Cederb/Faceshield.nu/Pictures/breakaway_stack2.jpg

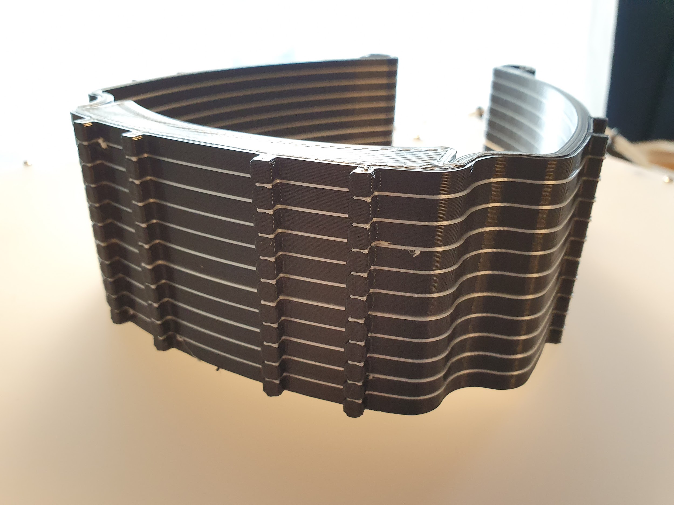
Pictures/breakaway_stack2.jpg
