Cederb/Faceshield.nu/Pictures/breakaway_stack1.jpg

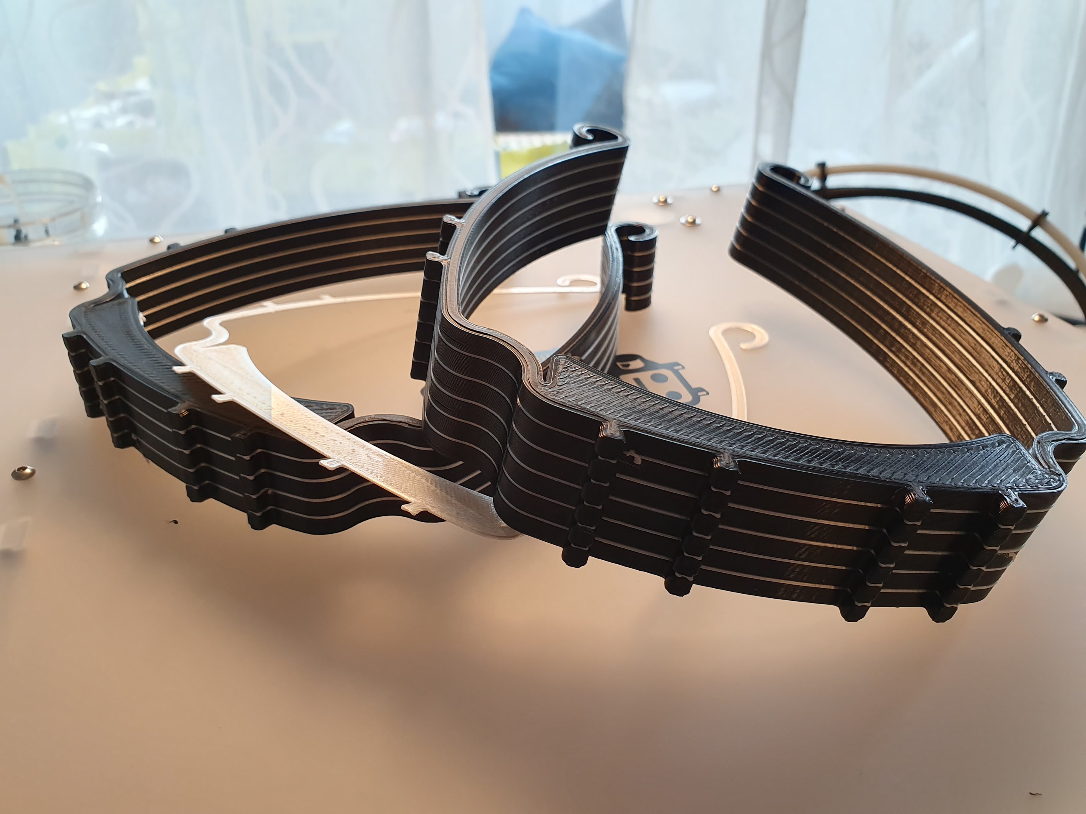
Pictures/breakaway_stack1.jpg
