Cederb/Faceshield.nu/README.md

# Faceshield.nu
 Backup repo for the Faceshield.nu project. Please see http://faceshield.nu for information.
