Cederb/Faceshield.nu/North America 3-hole/Templates & Laser Cutting files/US__3_Hole_Punch_Letter_Template by Bornity.pdf

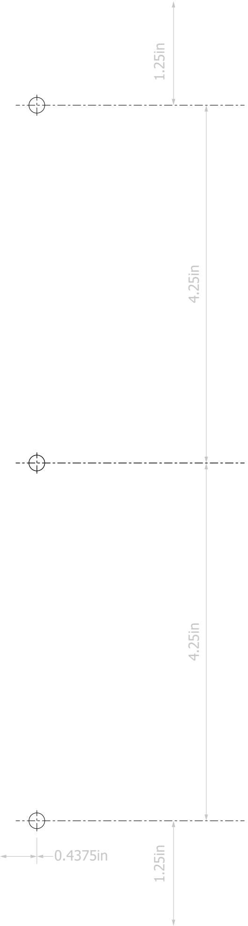
[picture p3: figure]

# 3DVerkstan NA 3-hole Hand Punch Template

# (USES STANDARD USA 3-HOLE PUNCH

)

Created by Rob Stuart (@bornity)

Modified for 3-hole version by Erik Cederberg (@erikcederb)
