Cederb/Faceshield.nu/North America 6-hole/Templates & Laser Cutting files/US__6_Hole_Punch_Letter_Template by Bornity.pdf

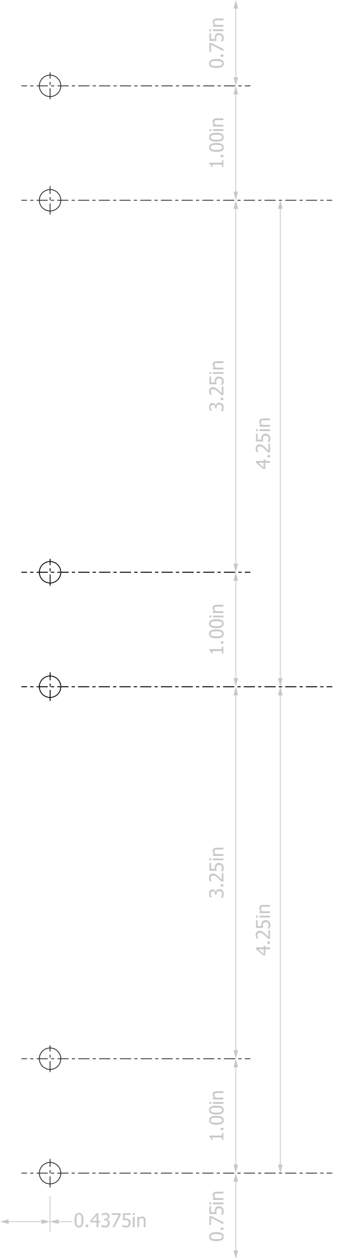
[picture p4: figure]

## 3DVerkstan NA V3 Hand Punch Template

## (USES STANDARD USA 3-HOLE PUNCH TWICE

)

Created by Rob Stuart (@bornity)
