Cederb/Faceshield.nu/Pictures/breakaway_stack3.jpg

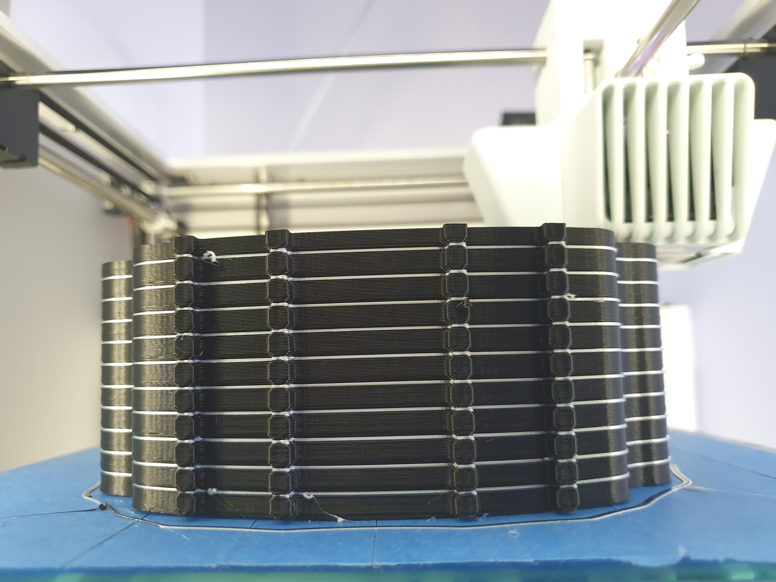
Pictures/breakaway_stack3.jpg
