Cederb/Faceshield.nu/Visor_frame_EUROPE-888-4hole.png

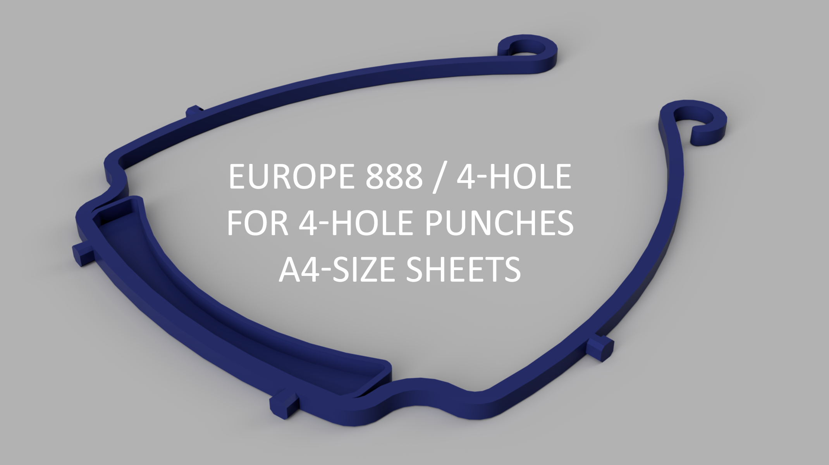
Visor_frame_EUROPE-888-4hole.png
