Cederb/Faceshield.nu/Visor_frame_EUROPE-ISO838_A6.png

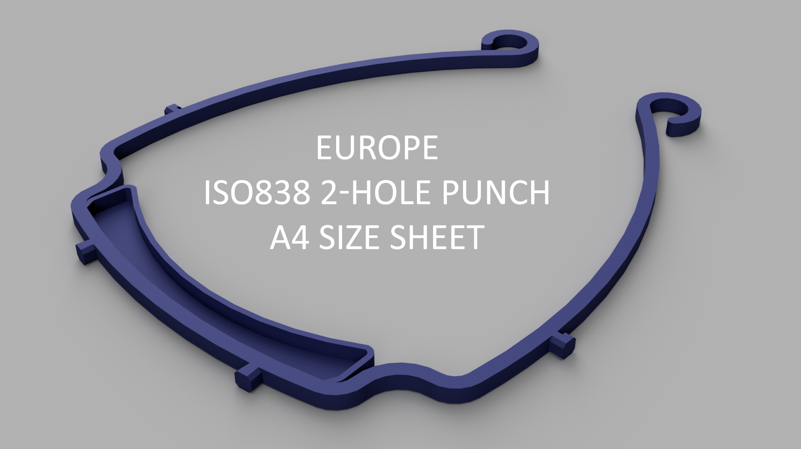
Visor_frame_EUROPE-ISO838_A6.png
