Cederb/Faceshield.nu/Visor_frame_NORTH-AMERICA_3-hole.png

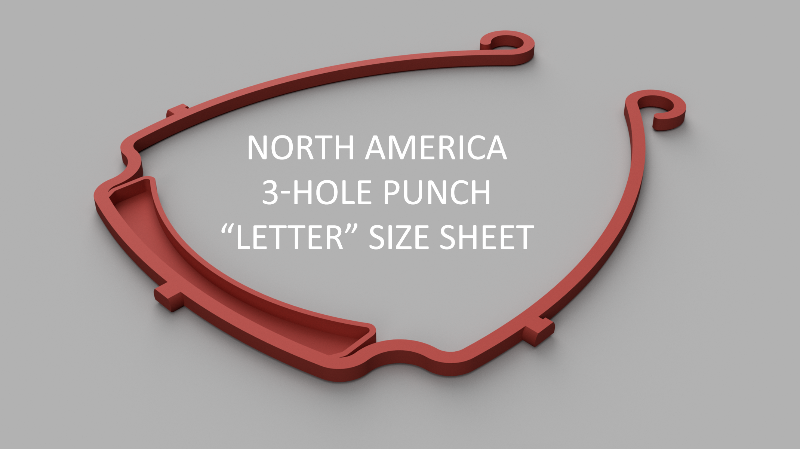
Visor_frame_NORTH-AMERICA_3-hole.png
