Cederb/Faceshield.nu/Visor_frame_NORTH-AMERICA_6-hole.png

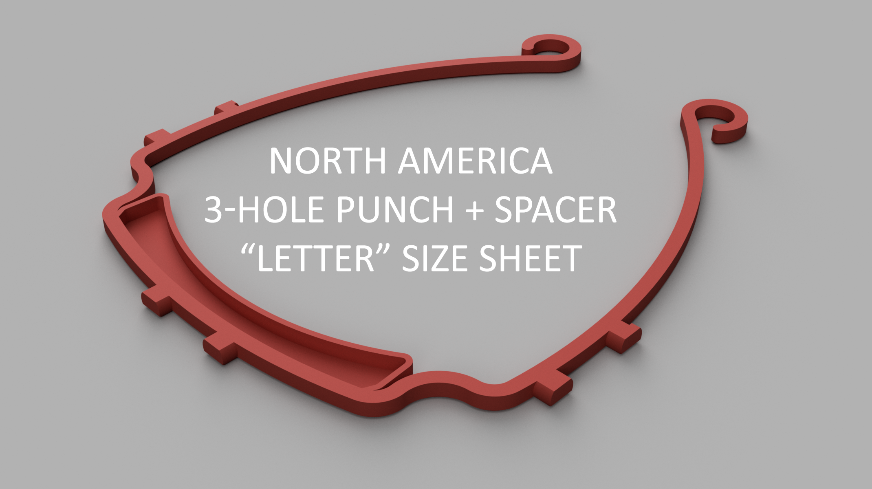
Visor_frame_NORTH-AMERICA_6-hole.png
