Cederb/Faceshield.nu/Visor_frame_PRUSA-COMPATIBLE.png

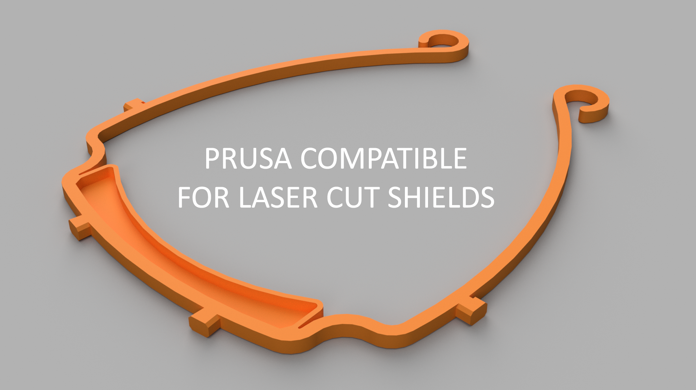
Visor_frame_PRUSA-COMPATIBLE.png
