Cederb/Faceshield.nu/Visor_frame_SWEDEN_A6.png

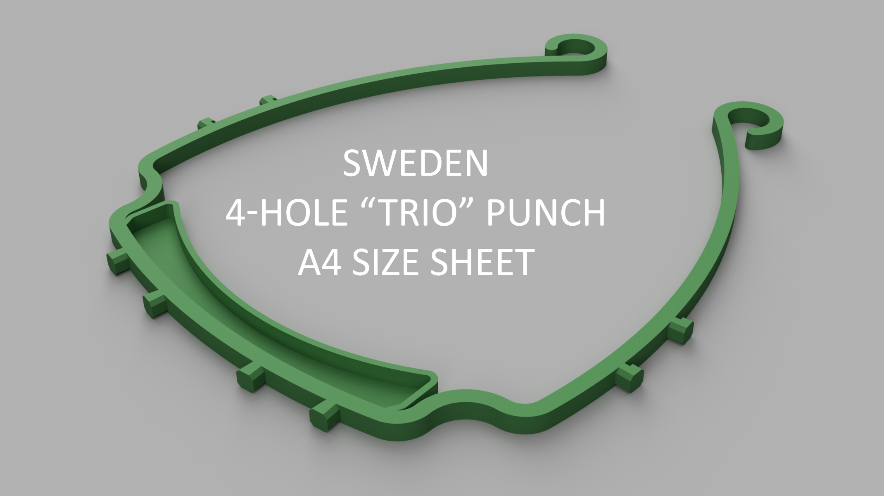
Visor_frame_SWEDEN_A6.png
