Cederb/Faceshield.nu/Europe 888/3D Printing Files (STL)/Stacked Files/For Dual Extrusion Printers/Visor_frame_EUROPE_80mm_4hole_v2-solid_front-support_stack_17pcs_95mm.stl

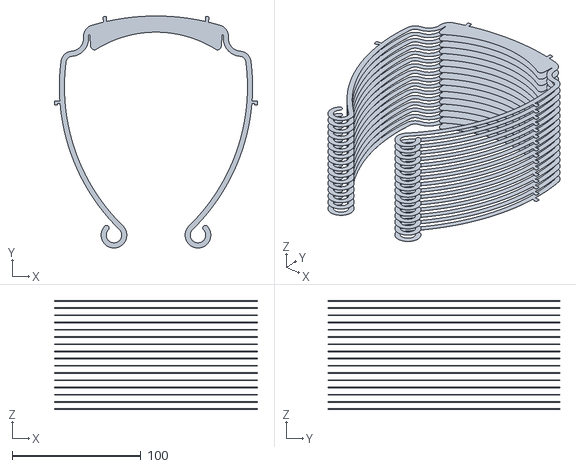
[picture p12: CAD file, 2020-04-02]
Europe 888/3D Printing Files (STL)/Stacked Files/For Dual Extrusion Printers/Visor_frame_EUROPE_80mm_4hole_v2-solid_front-support_stack_17pcs_95mm.stl
157.8 x 180.1 x 84.6
