Cederb/Faceshield.nu/Europe 888/3D Printing Files (STL)/Visor_frame_EUROPE_80mm_4hole_v2.stl

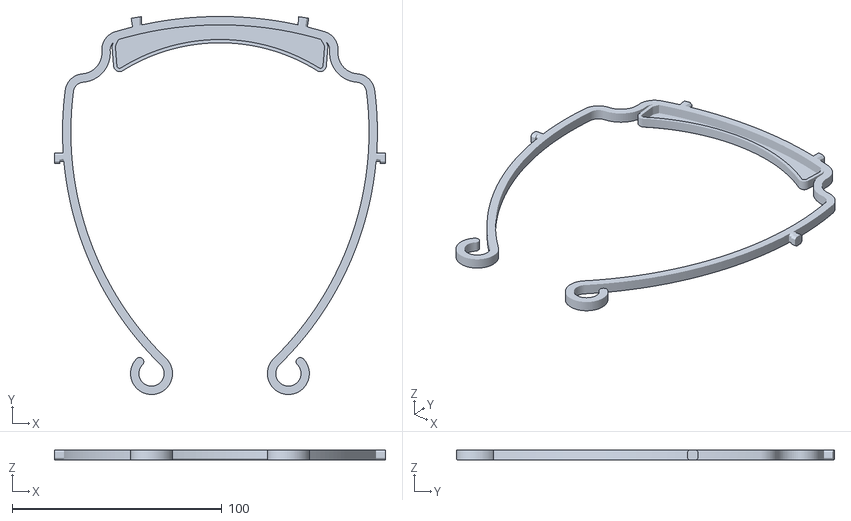
[picture p14: CAD file, 2020-04-02]
Europe 888/3D Printing Files (STL)/Visor_frame_EUROPE_80mm_4hole_v2.stl
157.8 x 180.1 x 5.00
