Cederb/Faceshield.nu/Europe 888/Templates & Laser Cutting files/Lasercut-shield-EUROPE-4hole.dxf

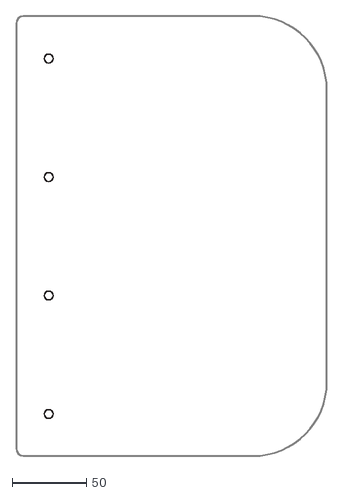
[picture p15: CAD file, 2020-03-27]
Europe 888/Templates & Laser Cutting files/Lasercut-shield-EUROPE-4hole.dxf
210.0 x 297.0
