Cederb/Faceshield.nu/Europe ISO838/Build plates & GCode/PRUSA-MK3S_0.4mm_PLA_Visor_frame_EUROPE_ISO838_v3.3mf

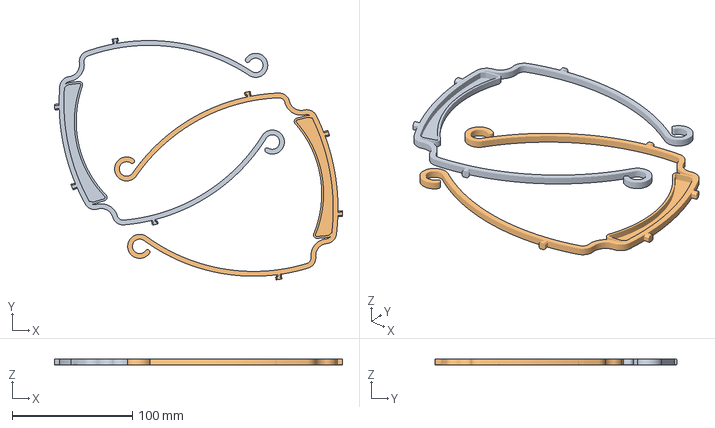
[picture p16: CAD file, 2020-03-26]
Europe ISO838/Build plates & GCode/PRUSA-MK3S_0.4mm_PLA_Visor_frame_EUROPE_ISO838_v3.3mf
239.2 x 200.8 x 5.00 mm
