Cederb/Faceshield.nu/Europe ISO838/Templates & Laser Cutting files/Lasercut-shield-EUROPE-4hole.dxf

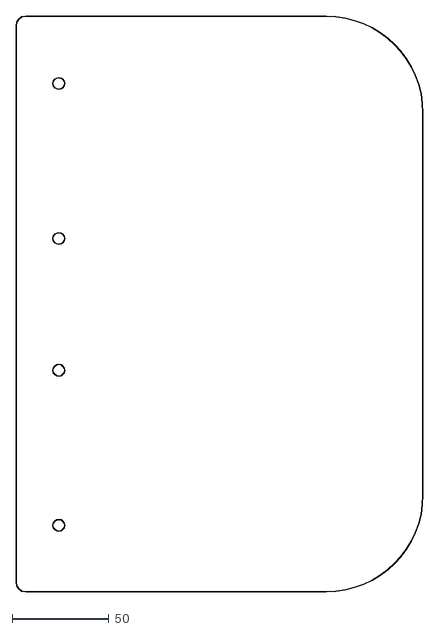
[picture p17: CAD file, 2020-04-10]
Europe ISO838/Templates & Laser Cutting files/Lasercut-shield-EUROPE-4hole.dxf
210.0 x 297.0
