Cederb/Faceshield.nu/North America 6-hole/Templates & Laser Cutting files/US 6 Hole Template by Joel Telling.dxf

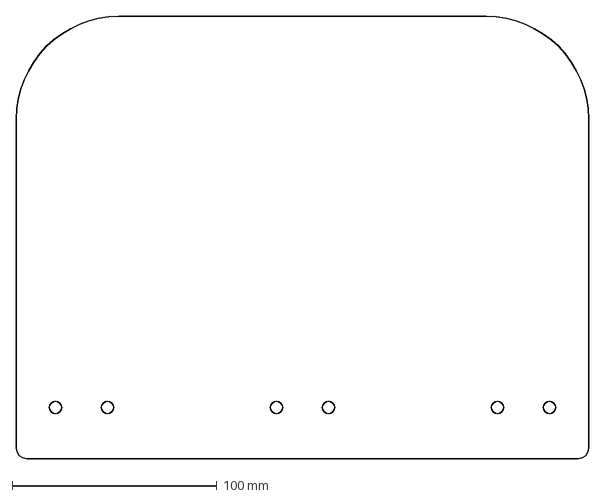
[picture p18: CAD file, 2020-03-26]
North America 6-hole/Templates & Laser Cutting files/US 6 Hole Template by Joel Telling.dxf
279.4 x 215.9 mm
