Cederb/Faceshield.nu/Sweden/3D Printing Files (STL)/Stacked Versions/For Stratasys printers/Visor_Frame_Stacked_10_pcs_Sweden_V10.stl

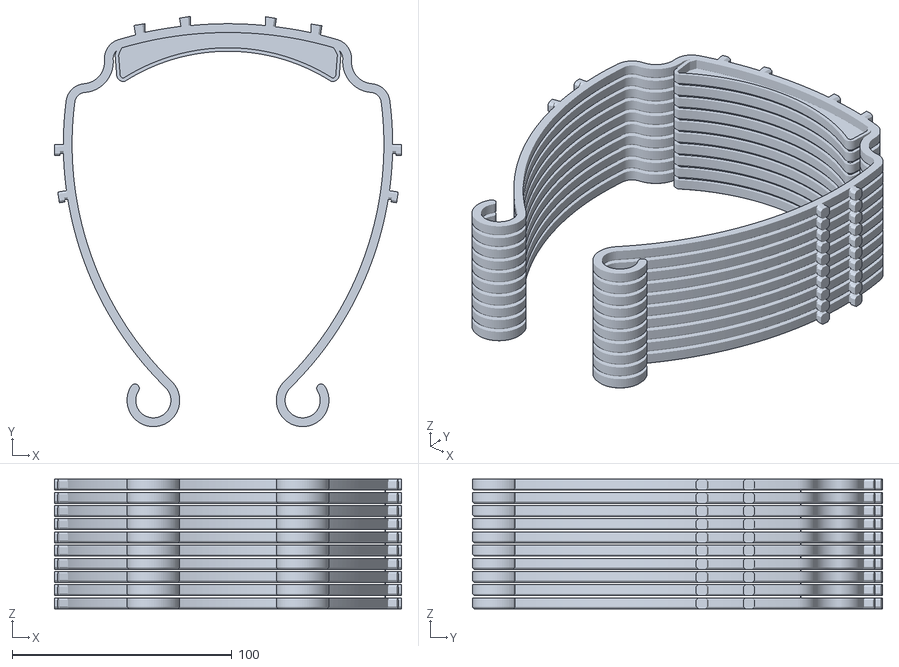
[picture p19: CAD file, 2020-03-27]
Sweden/3D Printing Files (STL)/Stacked Versions/For Stratasys printers/Visor_Frame_Stacked_10_pcs_Sweden_V10.stl
158.0 x 186.9 x 59.0
