Cederb/Faceshield.nu/Sweden/Build plates & GCode/UM3_CURA_JOB_Visor_frame_SWEDEN_v10.3mf

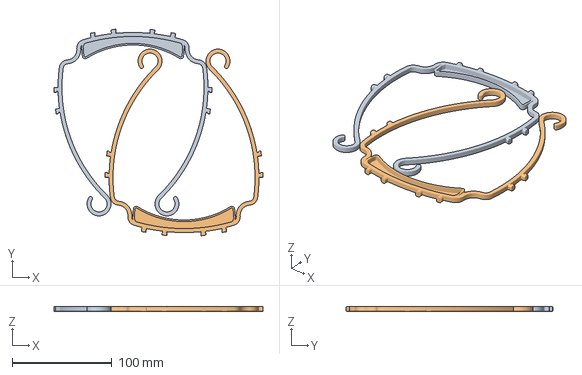
[picture p20: CAD file, 2020-03-26]
Sweden/Build plates & GCode/UM3_CURA_JOB_Visor_frame_SWEDEN_v10.3mf
209.1 x 206.8 x 5.00 mm
