Cederb/Faceshield.nu/Sweden/Templates & Laser Cutting files/Letter-sized-shield-for-SWEDEN-frame-lasercut.dxf

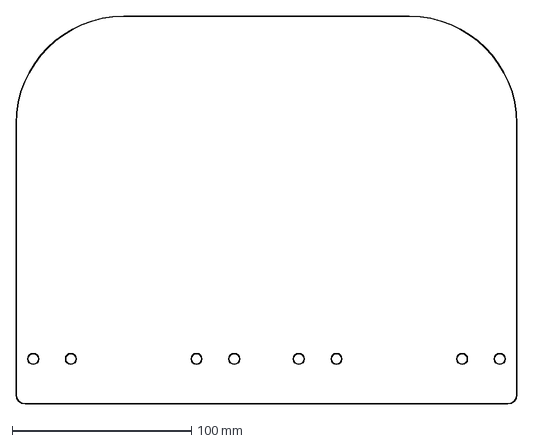
[picture p21: CAD file, 2020-03-26]
Sweden/Templates & Laser Cutting files/Letter-sized-shield-for-SWEDEN-frame-lasercut.dxf
279.0 x 216.0 mm
