Cederb/Faceshield.nu/North America 6-hole/3D Printing Files (STL)/Letter-spacer-6hole.stl

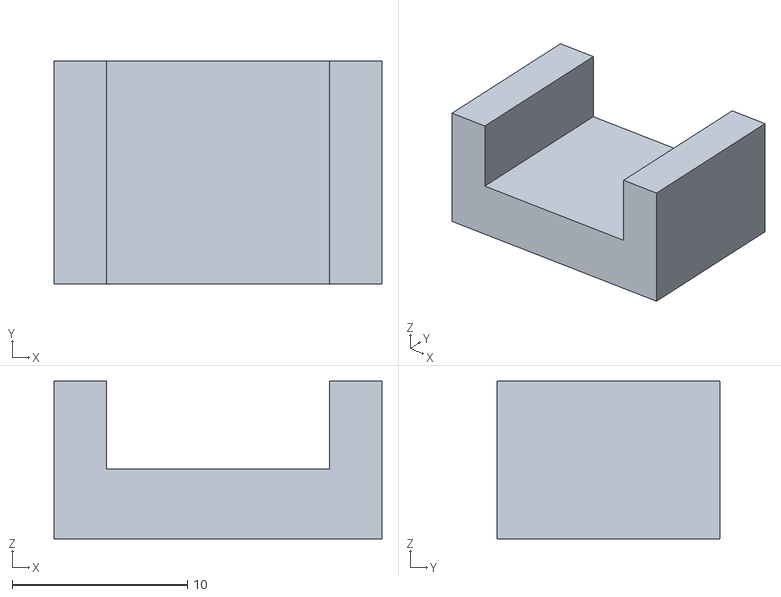
[picture p22: CAD file, 2020-03-26]
North America 6-hole/3D Printing Files (STL)/Letter-spacer-6hole.stl
18.7 x 12.7 x 9.00
