Cederb/Faceshield.nu/Sweden/Templates & Laser Cutting files/Lasercut-shield-SWEDEN-A4.dxf

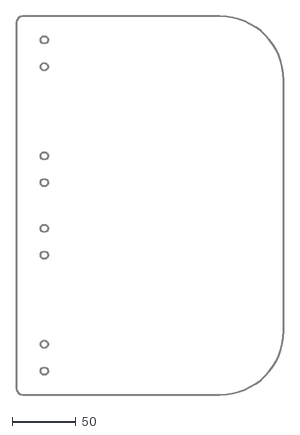
[picture p23: CAD file, 2020-03-26]
Sweden/Templates & Laser Cutting files/Lasercut-shield-SWEDEN-A4.dxf
210.0 x 297.0
