Cederb/Faceshield.nu/Sweden/Templates & Laser Cutting files/Letter-sized-shield-for-SWEDEN-frame-template.dxf

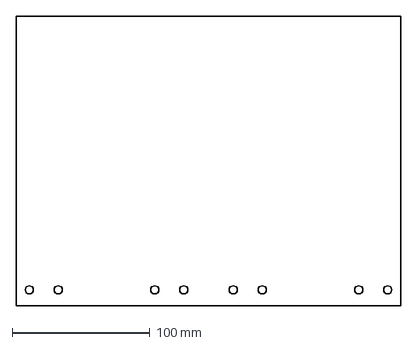
[picture p24: CAD file, 2020-03-26]
Sweden/Templates & Laser Cutting files/Letter-sized-shield-for-SWEDEN-frame-template.dxf
279.0 x 210.0 mm
