Cederb/Faceshield.nu/(list of files, cad)

Other CAD files:
Europe ISO838/3D Printing Files (STL)/Stacked Files/For Dual Extrusion Printers/Visor_frame_EUROPE_ISO838_v4-solid_front-support_stack_17pcs_95mm.stl
Europe ISO838/3D Printing Files (STL)/Thicker brow/Visor_frame_EUROPE_ISO838_v4-solid_front.stl
Europe ISO838/3D Printing Files (STL)/Visor_frame_EUROPE_ISO838_v4.stl
North America 3-hole/3D Printing Files (STL)/Stacked files/For Dual Extrusion Printers/Visor_Frame_NORTH_AMERICA_letter_3-hole_v4-solid_front-support_stack_17pcs_95mm.stl
North America 3-hole/3D Printing Files (STL)/Thicker brow/Visor_Frame_NORTH_AMERICA_letter_3-hole_v4-solid_front.stl
North America 3-hole/3D Printing Files (STL)/Visor_Frame_NORTH_AMERICA_letter_3-hole_v4.stl
North America 6-hole/3D Printing Files (STL)/Thicker brow/Visor_Frame_NORTH_AMERICA_letter_6-hole_v5-solid_front.stl
North America 6-hole/3D Printing Files (STL)/Visor_Frame_NORTH_AMERICA_letter_6-hole_v5.stl
Prusa Compatible/3D Printing Files (STL)/Stacked files/For Dual Extrusion Printers/Visor_Frame_PRUSA_COMPATIBLE_v1-support_stack_17pcs_95mm.stl
Prusa Compatible/3D Printing Files (STL)/Thicker brow/Visor_Frame_PRUSA_COMPATIBLE_solid-front.stl
Prusa Compatible/3D Printing Files (STL)/Visor_Frame_PRUSA_COMPATIBLE_v1.stl
Sweden/3D Printing Files (STL)/Stacked Versions/For dual extrusion printers/Visor Frame_SWEDEN_V11-solid_front-support_stack_17pcs_95mm.stl
Sweden/3D Printing Files (STL)/Visor_frame_SWEDEN_v11.stl
Europe 888/3D Printing Files (STL)/Thicker brow/Visor_frame_EUROPE_80mm_4hole_v2-1mm_front.stl
Europe ISO838/3D Printing Files (STL)/Thicker brow/Visor_frame_EUROPE_ISO838_v4-1mm_front.stl
North America 3-hole/3D Printing Files (STL)/Thicker brow/Visor_Frame_NORTH_AMERICA_letter_3-hole_v4-1mm_front.stl
North America 6-hole/3D Printing Files (STL)/Thicker brow/Visor_Frame_NORTH_AMERICA_letter_6-hole_v5-1mm_front.stl
Prusa Compatible/3D Printing Files (STL)/Thicker brow/Visor_Frame_PRUSA_COMPATIBLE_1mm-front.stl
Sweden/3D Printing Files (STL)/Stacked Versions/For Stratasys printers/StackedPrinting_stratasys.stl
Sweden/3D Printing Files (STL)/Visor Frame_SWEDEN_V11-1mm_front.stl
Sweden/3D Printing Files (STL)/Visor Frame_SWEDEN_V11-solid_front.stl
Europe 888/3D Printing Files (STL)/Old versions/Visor_frame_EUROPE_80mm_4hole_v1.stl
Europe ISO838/3D Printing Files (STL)/Old versions/Visor_frame_EUROPE_ISO838_v3.stl
North America 3-hole/3D Printing Files (STL)/Old versions/Visor_Frame_NORTH_AMERICA_letter_3-hole-v2.stl
Sweden/3D Printing Files (STL)/Old versions/Visor_frame-SWEDEN_v10-stronger-front.stl
Sweden/3D Printing Files (STL)/Old versions/Visor_frame_SWEDEN_v10.stl
