Cederb/Faceshield.nu/Sweden/manual_skyddsvisir.pdf

# Bruksanvisning för skyddsvisir modell ”3DVerkstan”

OBS! Notera att detta visir är tänkt som ett alternativ ENDAST OM INTE GODKÄNDA SKYDD KAN ERHÅLLAS! Tillverkaren tar inget ansvar för bruket av detta visir. Denna konstruktion är designad av Erik Cederberg på 3Dverkstan Nordic AB, och produceras av mängder av privatpersoner och företag runt om landet.
Detta visir är godkänt som en tillfällig lösning av flertalet landsting i Sverige, men skall endast ses som ett komplement tills godkänd utrustning finns att tillgå.

!

Detta skydd består av 3 delar. Huvudbågen, ett visir gjort av Oh-film ( instruktioner för att skapa dessa visir finns nedan) + gummiband för att hålla ihop konstruktionen över bakhuvudet som så önskas. Visiret av OH-film bör ses som en engångsprodukt och ersättas när den är förbrukad, huvudbågen däremot kan spritas och användas igen.

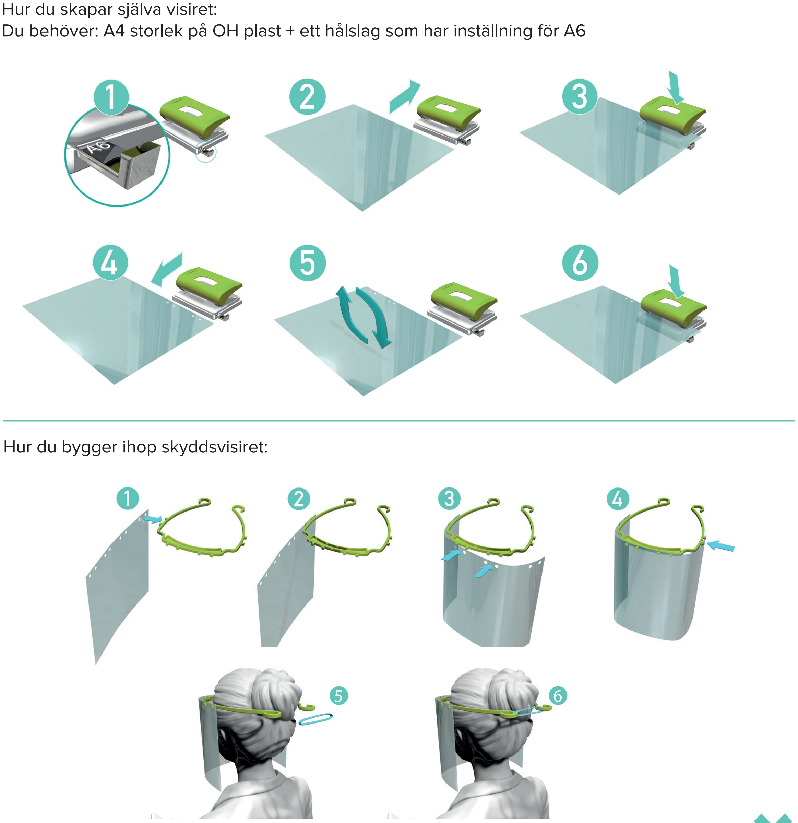
[picture p36: figure]
Hur du skapar själva visiret:; Hur du bygger ihop skyddsvisiret:

## Du behöver: A4 storlek på OH plast + ett hålslag som har inställning för A6

Denna manual är baserad på material skapat av Visor Air Göteborg / www.visoraidgoteborg.se
