Cederb/Faceshield.nu/Top Covers/How-to-make-top-covers_RU.pdf

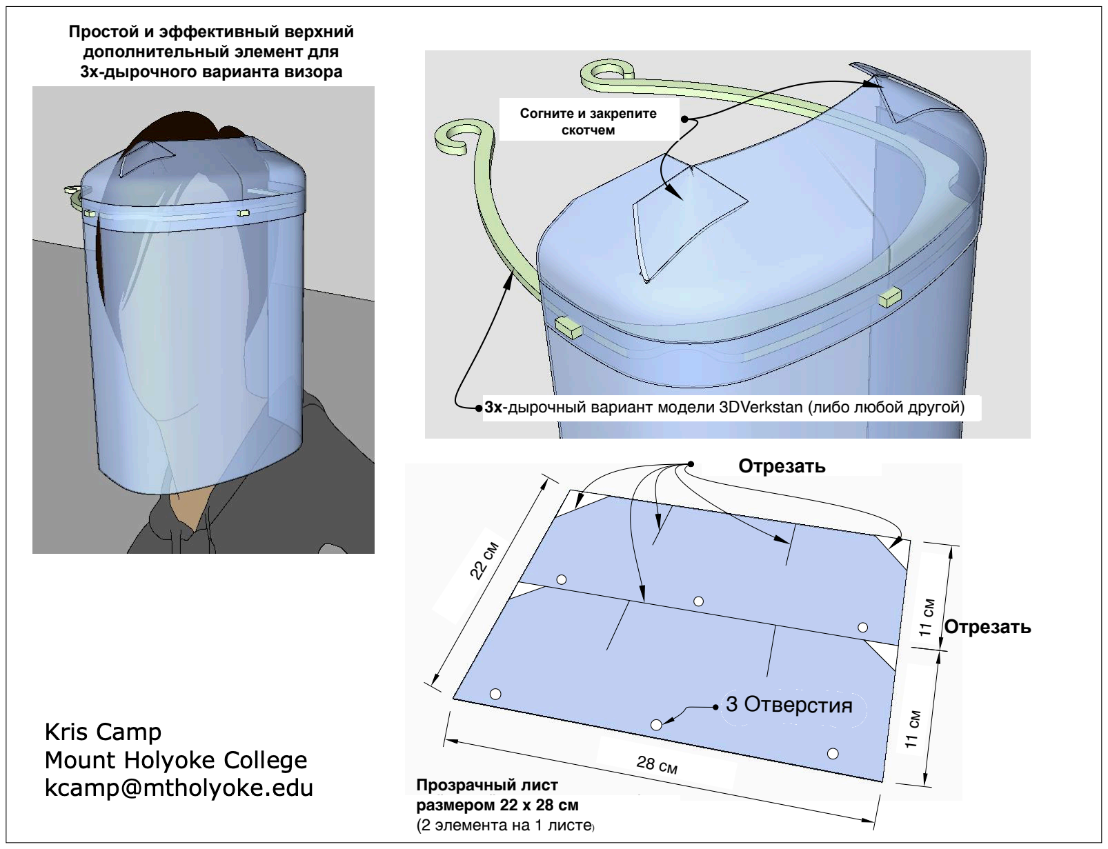
[picture p37: page 1]

Согните и закрепите
скотчем

Простой и эффективный верхний дополнительный элемент для 3х-дырочного варианта визора

## Отрезать

## Отрезать

Прозрачный лист
размером 22 х 28 см
(2 элемента на 1 листе)

28 см

22 см

## 3 Отверстия

11

см

11

см

3х-дырочный вариант модели 3DVerkstan (либо любой другой)
