Cederb/Faceshield.nu/(threads)

Thread 4 (2020-03-29):

there are no 80mm between the centrale hole on V3

gaelalso, 2020-03-29:
Hi, thanks you for your job,
there are no 80mm between the centrale hole on V3 ISO838
on v1 it's ok.

there are a reason?

Cederb, 2020-03-30:
ISO838 versions is made to accomodate the standard 80mm 2-hole punch, set to A6 format and punched once on either side, this gives a center distance of closer to 68mm than 80mm.

Closed 2020-03-30.

Thread 6 (2020-03-29):

1 inch spacer

lgebhardt, 2020-03-29:
I have a pack of report cover sheet material that's a bit over 11 inches. If you make the spacer 1" (25.4mm) long you don't need to turn the sheet over, just punch with and without the spacer in place. It will work with any size sheet as long as it's long enough to contain the holes. That should make it more flexible. If you only resize the one dimension the spacer will work either way.

Cederb, 2020-03-30:
Yes, you can absolutely do this. Having a spacer fixed and just flip the sheet is the faster way of doing it when doing many in repeated fashion, since you don't have to change anything to the hole punch setting.

Btw, with true 11" sheets, you can also just set the hole punch to 12" and flip the sheet, it gives the same effect as the spacer.

Closed 2020-03-30.

Thread 7 (2020-03-30):

Pegs too big for hole punch

indyjason79, 2020-03-30:
First off, thank you for making these! On the North American version the pegs are larger (elliptical instead of circular). I'm having to double punch the same hole twice to make it fit which is making some of the shields fall off the visor. Why was this done differently and can we get a North American version with round pegs like the other versions please? I need to print hundreds of these and it's going to screw things up if I have to double punch all the holes.

Cederb, 2020-03-30:
Hi

The North american hole punches does not have a very tightly defined standard, with holes allowed to be anything between 1/4" and 5/16", with many trending towards the larger, so the pegs were made to allow for the larger size of the hole punches in common use.

indyjason79, 2020-03-30:
Thanks for the clarification. Maybe it's because I'm using a hand hole punch instead of a big one.

indyjason79, 2020-03-30:
FYI, someone created a stackable version of your model. You may want to add it to your zip on your website. https://www.thingiverse.com/thing:4247264/comments

Cederb, 2020-03-30:
About the stacking, see: https://github.com/Cederb/Faceshield.nu/pull/5

indyjason79, 2020-03-31:
After switching to a desktop version of a 3 hole punch machine this isn't an issue anymore. It was just the hand-held hole punch that didn't make the holes big enough.

Closed 2020-03-30.

Thread 8 (2020-04-01):

Transparent plastic sheet detach

GuillaumeSTEIN, 2020-04-01:
Hi,

I printed the Visor_frame_EUROPE_80mm_4hole_v1.stl file and the holes are well aligned.
But the transparent sheet is too loose and easily get off the structure.
Here is a video to illustrate it : https://www.youtube.com/watch?v=HHXnbsCBFrk

I'm thinking about printing it to 101% or more to make it more rigid.
Or maybe a ring to lock the sheet

Do you have any idea ?

Cederb, 2020-04-01:
Ok, got this feedback from a few more comments, will update that version with a slightly tighter fit.

GuillaumeSTEIN, 2020-04-02:
Ok I now print it in 101%, it fixed my issue.
More % will deform the holes.

Cederb, 2020-04-03:
The latest version pushed has 1mm tighter spacing for the holes on the EU 80mm version.

Closed 2020-04-02.

Thread 12 (2020-04-02):

Top shield - gaps

graiz, 2020-04-02:
I got feedback from one of the hospitals that I'm working with that they would like to eliminate the gap/hole between the mask edge and the face.

I made a variation that looks like this:
https://imgur.com/PjLiYEI

Note a 1/2mm gap to allow the arm to continue to flex.
https://imgur.com/jJZd2q8

For hospitals that aren't using the top-shield, it provides some additional shielding from the downward spray.  Happy to provide the reference designs if needed.

Sarashorin, 2020-04-02:
Would love the design link to fill in the gaps.  Thanks so much!!! Looks good!!! Sarashorin@gmail.com

Sarashorin, 2020-04-02:
I agree, hospitals want to fill the gap

graiz, 2020-04-03:
I have my draft STL here. I prefer not to fork the core design hosted here. If this issue gets resolved I would prefer to delete my version. https://www.thingiverse.com/thing:4257419

Cederb, 2020-04-03:
Even like what you have done now, you joined the curves and removed more than half of the flex in the front, making it fit less well on a wide range of head sizes, especially with stiff filaments like PLA.

You also introduced a thin plane that have a edge right into the forehead that will be much more fragile, and by trying to fill the curve all the way to the radius of the plastic shield , you reduced the allowed tolerance for misplaced holes by quite a bit.

I do not see this as a universal improvement and there is a very thin line between how much to cover up vs how robust the design is for different materials and low printing tolerances. We have some people pushing these out with 1mm+ nozzles in ten minutes, and then there is no such thing there as a 0.5mm slot.

Cederb, 2020-04-03:
This whole red marked section is acting as the spring to let it conform to a wide range of head sizes, not just the arm:
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

graiz, 2020-04-03:
Yes. That's why I'm calling my design a draft.  I don't have the original files so I was just mesh editing. This issue is a request to modify the original design with my image as a reference in terms of what I'm describing.

Cederb, 2020-04-03:
I have tried making it more closed in multiple revisions, and it is honestly not that easy without making it flex way less or become very tightly tolerance dependent on the printing.

And what i mean with the front curve is that the shield plastic should be able to sit either like the line on the right or the one on the left to take up differences in hole placements.
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

Sarashorin, 2020-04-03:
Thank you so much!!! Much appreciated!!

Be well, stay well!
Sara

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

graiz, 2020-04-03:
@Cederb  - I was able to get it to flex reasonably by adding a few cuts to three places.  I'm printing with a 0.4mm nozzle and it hasn't been an issue because the printer still positions at sub-mm precision. It just can't extrude a very thin line but it doesn't have a problem keeping inside of this. I added three features.   1. Inner bend cut.  2. Outer bend cut. 3. Added arm flex.

I've shown what my draft looks like. Printing now.  https://imgur.com/a/aR66yln

Cederb, 2020-04-03:
@graiz - As i said, one of my design goals is for the design to be extremely robust and tolerant to printing tolerances, 0.5mm slots is not a thing that matches that goal.

Your added arm flex does increase printing time, reduces the possibility to print well with larger nozzles, and it also makes it harder to wipe to clean/disinfect. Every feature i include has to be printable with at least 0.8mm nozzle size, preferably 1mm, and as much as possible just with continous outlines, this is why all the things in the design share specific dimensions to make it able to be a multiple of the line width.

gregsvo, 2020-04-04:
I created a fork with the top covers that maintains the flexibility of the visors: https://github.com/gregsvo/Faceshield.nu/tree/master/north_america_6_hole_improved

The version I edited are the north-american 6-hole version, but on my fork I included step, stl, and fusion 360 for your own editing.

I have a single extruder and was frustrated at only making a single visor at a time, so now they print as three units, and a single drop of superglue holds the arms in their locking mechanism. @Cederb @graiz @Sarashorin

graiz, 2020-04-05:
Looks great. Trying to print this soon.  A side benefit of this approach is that I can get more masks on the build plate per print.   https://imgur.com/a/9uN6O6r
Your visor design looks much better too.   Thank you!  If I can buy you a roll or two of filament, send me your venmo.

graiz, 2020-04-06:
FYI:  I printed the design and it works well but I don't like the parts falling out so easily because of tolerances.  I added a simple sphere snap-fit on both parts to allow the parts to snap and hold together.  Using a 2.2mm sphere and trying this now.  https://imgur.com/a/22vaq8B.

gregsvo, 2020-04-06:
@graiz I love that. Yeah I was just puting a drop of super glue to hold them in, but snap-fit is obviously a better solution. I appreciate the offer for filament! But I was given a couple of rolls and I've got more than enough. Keep up the fight!!!!

graiz, 2020-04-06:
FYI - Snap-fit printed without issue / no supports and the fit does snap-in at the current tolerances and does not come out easily. I was able to remove the arms but they are in there pretty tight.

JDU1, 2020-04-07:
tried to fix the problem, maybe someone wants to test it? the load is not too great. i also increased the distance from the forehead to the window, otherwise big noses would bump.

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

graiz, 2020-04-08:
@gregsvo  - I'm going to close this issue.  The fork you provided resolves the original issue I opened. I'm happy to provide the snap-fit edit if you'd like it and I'll leave it to you to either keep the forked branch or choose to merge it at some point.   Thanks.

Closed 2020-04-08.

Thread 13 (2020-04-02):

Stackable version for single extruders?

gregsvo, 2020-04-02:
Can you make a stacked version (like the makerbot dual-extruder) but for single extruders? With minimal supports between that can be snapped/cut apart? I'm providing units for a local hospital, but am only working with single-extruder units.

I would be happy to do this myself, if you'll provide an editable file type, preferably fusion360's `. f3d`

Thank you.

napter, 2020-04-03:
I'm trying the istack version [here](https://www.thingiverse.com/thing:4253743/files). They all separated but one on my first try but I printed hot so I'm trying again cooler.

Here are others I've found. If you get any to work and separate nicely let me know as well please! Ideally with layer height around 0.3 for faster printing.

- https://www.prusaprinters.org/prints/27274-3dveristan-face-shield-midsouth-makers-focus-versi/files
- https://www.thingiverse.com/thing:4255764
- https://www.thingiverse.com/thing:4247264/files

gcormier, 2020-04-07:
Did not have any luck with the efficient stack ( https://www.thingiverse.com/thing:4253743/files ) version. Separating them ended up causing a bit of damage. (0.25mm layers, PLA+)

gomako, 2020-04-10:
I have made a version that works ok on my printer [here](https://github.com/gomako/covid-19-face-shield). I am adding to the repo as I go. There are only stacks of two and four at the moment for testing, but I will add stacks of more over the coming days. Please let me know if they work for you by raising issues on my repo.

Cederb, 2020-04-11:
Since stacks has to be optimized for the layer height you intend to print them in, and it therefore is impossible for me to generate one stack that fits all needs, i recommend that you all use the free version of the amazing 3D printing software LuBan and it's new stack generation feature to generate your single extrusion stacks. Read more here:

https://www.facebook.com/groups/1067858546711484/permalink/1491622321001769/

Closed 2020-04-11.

Thread 14 (2020-04-03):

Wrong spacing for North America

scates, 2020-04-03:
I find that the holes don't line up well for the North American 6-hole version.  Upon closer inspection, it appears that the pegs are spaced 110mm apart when they should be 108mm.

If I manually punch them with 110mm spacing, it fits onto the band much more nicely, but that's much more time-consuming than using a standard 3-hole punch with the half-inch spacer.

TheCre8r, 2020-04-03:
+1

TheCre8r, 2020-04-03:
@scates Temporary solution available is here:
https://github.com/city-of-henderson/Misc-3d-prints/tree/master/Spacer

scates, 2020-04-03:
I used OpenSCAD to hack together an adjusted version.  It works much better for me.  I created a pull request to add my OpenSCAD source and generated STL file: https://github.com/Cederb/Faceshield.nu/pull/16

blayed, 2020-04-10:
Hello, I fixed the version and recreated the solidworks file. You can find it here
https://www.youmagine.com/designs/verkstan-face-shield-north-american-6-hole-fixed

hywel-evans, 2020-04-11:
This version is missing the small tag to hold the sheet on the most rear-most pegs.

blayed, 2020-04-11:
> This version is missing the small tag to hold the sheet on the most rear-most pegs.

I have since fixed it. Check the link again for the latest files

hywel-evans, 2020-04-11:
Thanks

Thread 15 (2020-04-03):

Laser file for top cover?

napter, 2020-04-03:
Is there a laser cut file for the top cover? If not I can make it myself but looking at the guide, it shows a series of cuts but doesn't show the length of those cuts.

Cederb, 2020-04-05:
Hi

I would recommend this version if you want to laser cut it:
https://sophywong.com/addon

Closed 2020-04-05.

Thread 17 (2020-04-04):

Models are a bit big for small print beds

grytole, 2020-04-04:
The total length of the handle is 184.08mm for NA and 180.6mm for EU versions.
Prusa Mini has 180x180mm bed.
A reduce of arms length by 5mm will make it printable as is.

99% for EU and 97% for NA fits fine, but I'm not sure about the quality of connection with the sheet for scaled models.

Thread 18 (2020-04-05):

Chamfer the top edge PLEASE!

dbfrompw, 2020-04-05:
By putting a chamfer the top edge of the model, it will come out much better and be easier to print. less touch-up work after the print, nobody likes a sharp edged part.  And a Step file would be nice!

Thank you.

Cederb, 2020-04-05:
Chamfered edges does interfere with the slicer algorithms when slicing for large nozzles, making it very hard to get a solid part with only perimeters. This is why it is intentionally left sharp.

dbfrompw, 2020-04-05:
Bummer. I only have a .4 nozzle and have to hand work that top edge.

Sent from my iPhone

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

dbfrompw, 2020-04-06:
>
>
> Chamfered edges does interfere with the slicer algorithms when slicing for large nozzles, making it very hard to get a solid part with only perimeters. This is why it is intentionally left sharp.

could I take you out of the step file?

Cederb, 2020-04-06:
Send me a email at faceshield@3dverkstan.se. Not going to publish it openly since some people have been blatantly ignoring licenses and sharing the design with no attribution, claiming they created it, and being asses about it.

Closed 2020-04-06.

Thread 22 (2020-04-10):

DXF and PDF templates for ISO838 V4 are WRONG!

5N44P, 2020-04-10:
Hi guys,
in the europe iso838 file release the templates in PDF and DXF have a wrong distance between center holes.
Seems like they were never updated when the switch from v2 to v3 was made!
The distance between the center holes, as reported in https://github.com/Cederb/Faceshield.nu/issues/4#issuecomment-605923706, should be ~68mm

Closed 2020-04-10.

Thread 25 (2020-04-17):

Changelog for expediting NIH updates, NA version

mtitus83, 2020-04-17:
Please forgive me if I'm just overlooking something but I'm unable to locate a changelog or extrapolate changes for the model below from the git commit history.

Visor_Frame_NORTH_AMERICA_letter_6-hole_v5.stl

You may or may not be aware that your v3 model has undergone review and recommended when fabricated as instructed by the NIH which is a very important feature of your (and others) model to Medical Institutions in the US.

https://3dprint.nih.gov/discover/3dpx-013306

While seemingly simple if a changelog can be included, at least for this model, members of the community can better alert NIH of updates and get them approved faster.  Currently users visiting the NIH website seem to be downloading an old (NIH approved) version however on the other hand some users are seeking this out due to its standing with NIH and obtaining it from either github or YouImagine and are obtaining a version technically not approved, v5.

I understand the differences may be marginal and the request nuanced however I think this very simple solution will have a very critical benefit.

Closed 2024-08-25.

Thread 26 (2020-04-27):

Europe 888: 1mm front is actually 0.5mm

David-Defoort, 2020-04-27:
As far as I can tell, the front thickness of Europe 888 (Europe 888/3D Printing Files (STL)/Thicker brow/Visor_frame_EUROPE_80mm_4hole_v2-1mm_front.stl) is actually 0.5mm.
Would it be possible to fix it?
