Cederb/Faceshield.nu/Top Covers/How-to-make-top-covers.pdf

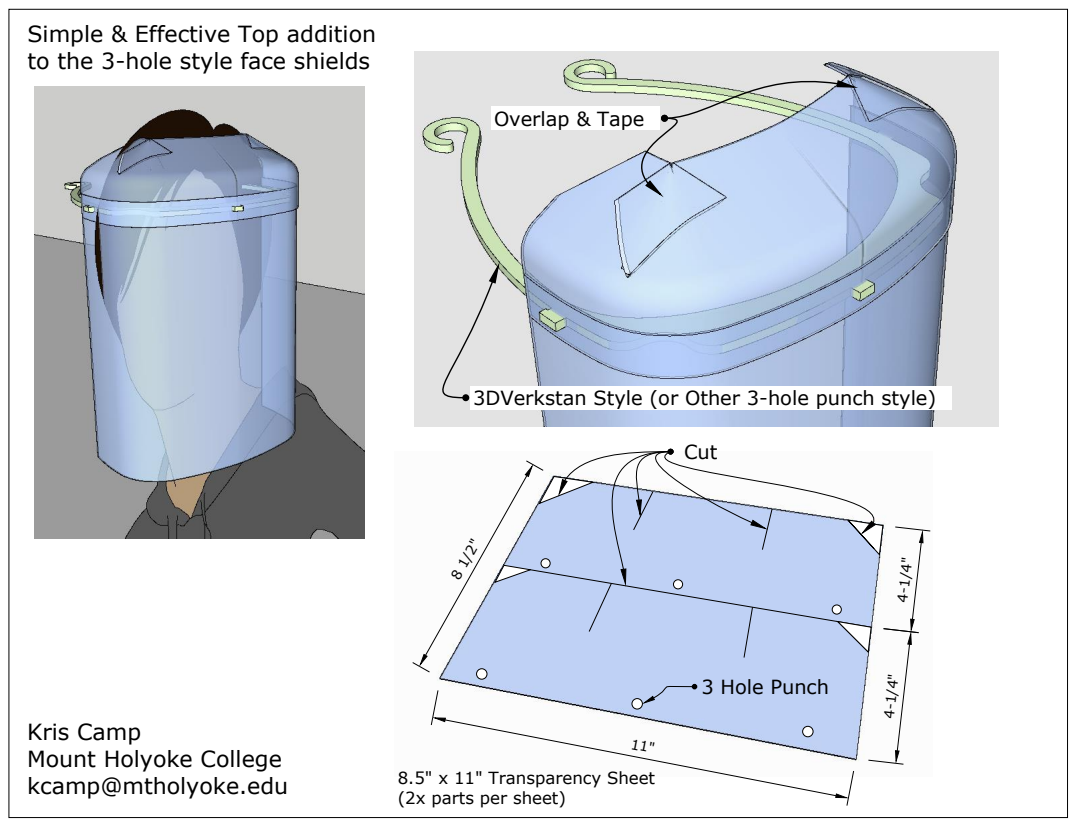
[picture p38: page 1]
Overlap & Tape; 3 Hole Punch

Simple & Effective Top addition
to the 3-hole style face shields

3DVerkstan Style (or Other 3-hole punch style)

Kris Camp
Mount Holyoke College
kcamp@mtholyoke.edu

8.5" x 11" Transparency Sheet
(2x parts per sheet)
