Cederb/Faceshield.nu/Prusa Compatible/Templates & Laser Cutting files/COVID19_SHIELD_FOIL_by_Prusa_Research.pdf

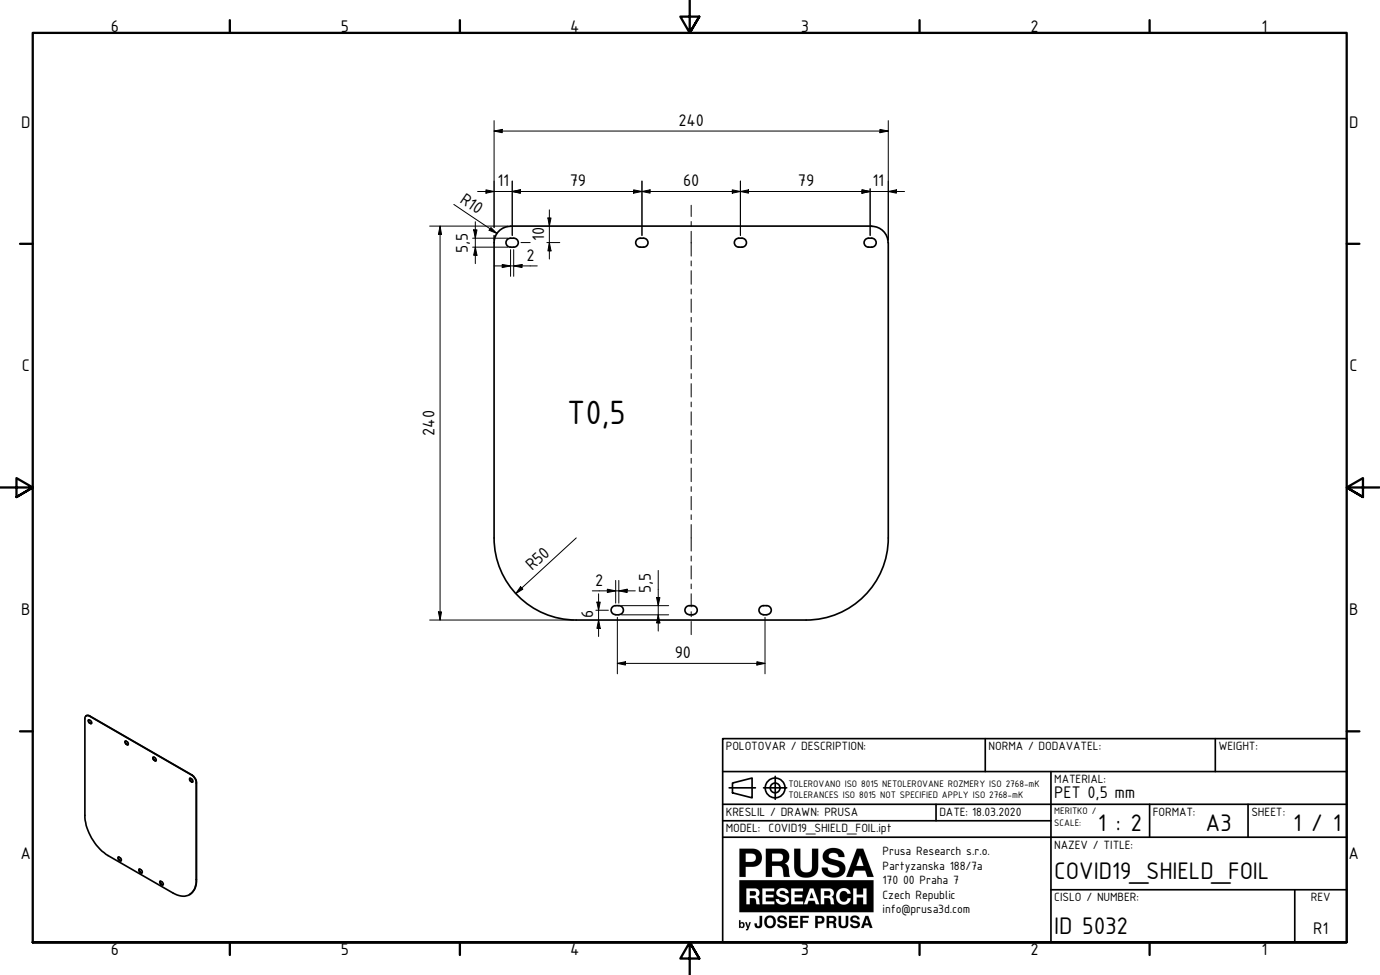
[picture p39: page 1]

POLOTOVAR / DESCRIPTION: | NORMA / DODAVATEL: | WEIGHT:

TOLEROVANO ISO 8015 NETOLEROVANE ROZMERY ISO 2768-mK
TOLERANCES ISO 8015 NOT SPECIFIED APPLY ISO 2768-mK

MATERIAL: PET 0,5 mm

KRESLIL / DRAWN: PRUSA | DATE: 18.03.2020 | MERITKO / 1 : 2 SCALE: | FORMAT: A3 | SHEET: 1 / 1

Prusa Research s.r.o. Partyzanska 188/7a 170 00 Praha 7 Czech Republic info@prusa3d.com | NAZEV / TITLE: COVID19_SHIELD_FOIL

CISLO / NUMBER: ID 5032 | REV R1
