Cederb/Faceshield.nu/(commit log)

2020-03-26 First upload
    [Lasercut-shield-A4.dxf, Lasercut-shield-NORTH-AMERICA-3-hole-letter-format.dxf, Lasercut-shield-NORTH-AMERICA-6-hole-letter-format.dxf, Letter-sized-shield-for-A4-frame-as-standard-paper.dxf, Letter-sized-shield-for-A4-frame-lasercut.dxf, Letter-spacer-6hole.stl, PRUSA-MK3S_0.4mm_PLA_Visor_frame_EUROPE_ISO838_v3.3mf, UM3_CURA_JOB_Visor_frame_SWEDEN_v10.3mf]
2020-03-26 added some build plates
2020-03-26 Added 6-hole templates from Joel Telling
    [US 6 Hole Template by Joel Telling.dxf]
2020-03-26 rename for clarity
    [Letter-sized-shield-for-A4-frame-template.dxf]
2020-03-27 Naming changes, some added gcode
    [Lasercut-shield-SWEDEN.dxf, Letter-sized-shield-for-SWEDEN-frame-lasercut.dxf, Letter-sized-shield-for-SWEDEN-frame-template.dxf]
2020-03-27 naming convention + extra templates
    [Lasercut-shield-EUROPE-4hole.dxf, Lasercut-shield-EUROPE-ISO838-A6.dxf, Lasercut-shield-SWEDEN-A4.dxf, Letter-sized-shield-for-A4-frame-as-standard-paper.dxf, Letter-sized-shield-for-A4-frame-lasercut.dxf]
2020-03-27 stacked prints for stratasys + fixed hole spacing on template
    [Lasercut-shield-NORTH-AMERICA-3-hole-letter-format.dxf, Lasercut-shield-NORTH-AMERICA-6-hole-letter-format.dxf, StackedPrinting_stratasys.stl, Visor_Frame_Stacked_10_pcs_Sweden_V10.stl]
2020-04-02 Added versions with thicker drip shields in the front, added 1mm extra tension to the 4-hole variants.
    [Visor Frame_SWEDEN_V11-1mm_front.stl, Visor Frame_SWEDEN_V11-solid_front.stl, Visor_Frame_NORTH_AMERICA_letter_3-hole-v2.stl, Visor_Frame_NORTH_AMERICA_letter_3-hole_v4-1mm_front.stl, Visor_Frame_NORTH_AMERICA_letter_3-hole_v4-solid_front.stl, Visor_Frame_NORTH_AMERICA_letter_3-hole_v4.stl, Visor_Frame_NORTH_AMERICA_letter_6-hole_v3.stl, Visor_Frame_NORTH_AMERICA_letter_6-hole_v5-1mm_front.stl]
2020-04-02 Added stacked versions for dual-extrusion printers like Ultimaker 3/S3/S5
    [Visor Frame_SWEDEN_V11-solid_front-support_stack_17pcs_95mm.stl, Visor_Frame_NORTH_AMERICA_letter_3-hole_v4-solid_front-support_stack_17pcs_95mm.stl, Visor_frame_EUROPE_80mm_4hole_v2-solid_front-support_stack_17pcs_95mm.stl, Visor_frame_EUROPE_ISO838_v4-solid_front-support_stack_17pcs_95mm.stl]
2020-04-03 Zip files of stacks + pictures of stacks + templates & instructions
    [Visor Frame_SWEDEN_V11-solid_front-support_stack_17pcs_95mm.stl]
2020-04-05 Directory restructuring
    [Lasercut-shield-EUROPE-4hole.dxf, Lasercut-shield-EUROPE-ISO838-A6.dxf, Lasercut-shield-NORTH-AMERICA-3-hole-letter-format.dxf, Lasercut-shield-NORTH-AMERICA-6-hole-letter-format.dxf, Letter-spacer-6hole.stl, PRUSA-MK3S_0.4mm_PLA_Visor_frame_EUROPE_ISO838_v3.3mf, StackedPrinting_stratasys.stl, US 6 Hole Template by Joel Telling.dxf]
2020-04-05 Version compatible with the Prusa shield hole pattern.
    [Visor_Frame_PRUSA_COMPATIBLE_1mm-front.stl, Visor_Frame_PRUSA_COMPATIBLE_solid-front.stl, Visor_Frame_PRUSA_COMPATIBLE_v1-support_stack_17pcs_95mm.stl, Visor_Frame_PRUSA_COMPATIBLE_v1.stl]
2020-04-10 Fixed ISO838 template in pdf and dxf
    [Lasercut-shield-EUROPE-4hole.dxf]
